eSpark-Backup/ezlo-ambient-tracker-pro-airbnb-hw/Deliverables/Main-PCB-v1.0/Renderings/3D_Top_View.png

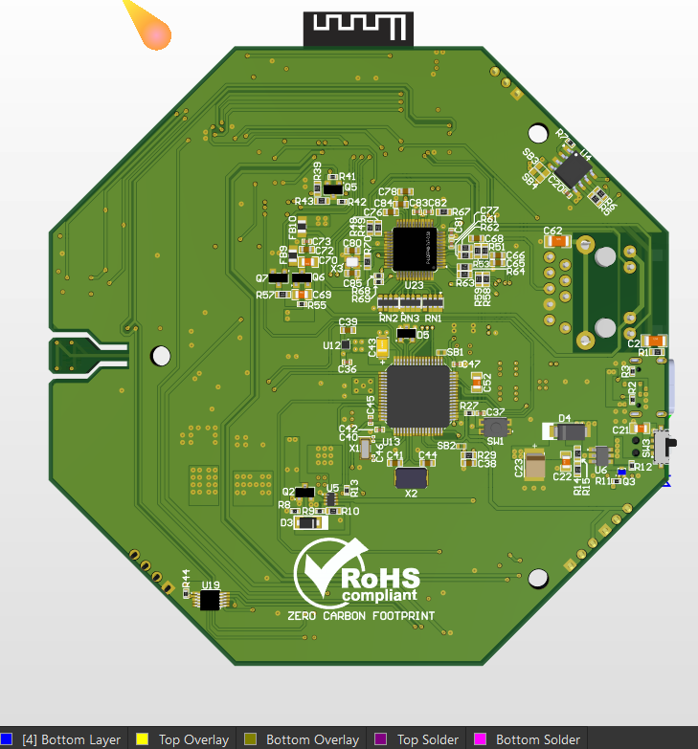
Deliverables/Main-PCB-v1.0/Renderings/3D_Top_View.png
