eSpark-Backup/ezlo-ambient-tracker-pro-airbnb-hw/(list of files, cad)

Other CAD files:
Deliverables/Main-PCB-v1.0/Supporting Files/AirBnB-v1.0.DWG
