eSpark-Backup/ezlo-ambient-tracker-pro-airbnb-hw/(list of files, drawings)

Other design files:
Design-Files/SecondaryPCB-airbnb/Secondary-PCB.PcbDoc
Design-Files/tracker-pro-airbnb-v1.0/Top-Sheet.SchDoc
