eSpark-Backup/ezlo-ambient-tracker-pro-airbnb-hw/Deliverables/Main-PCB-v1.0/Assembly Drawings/tracker-pro-airbnb-v1.0.pdf

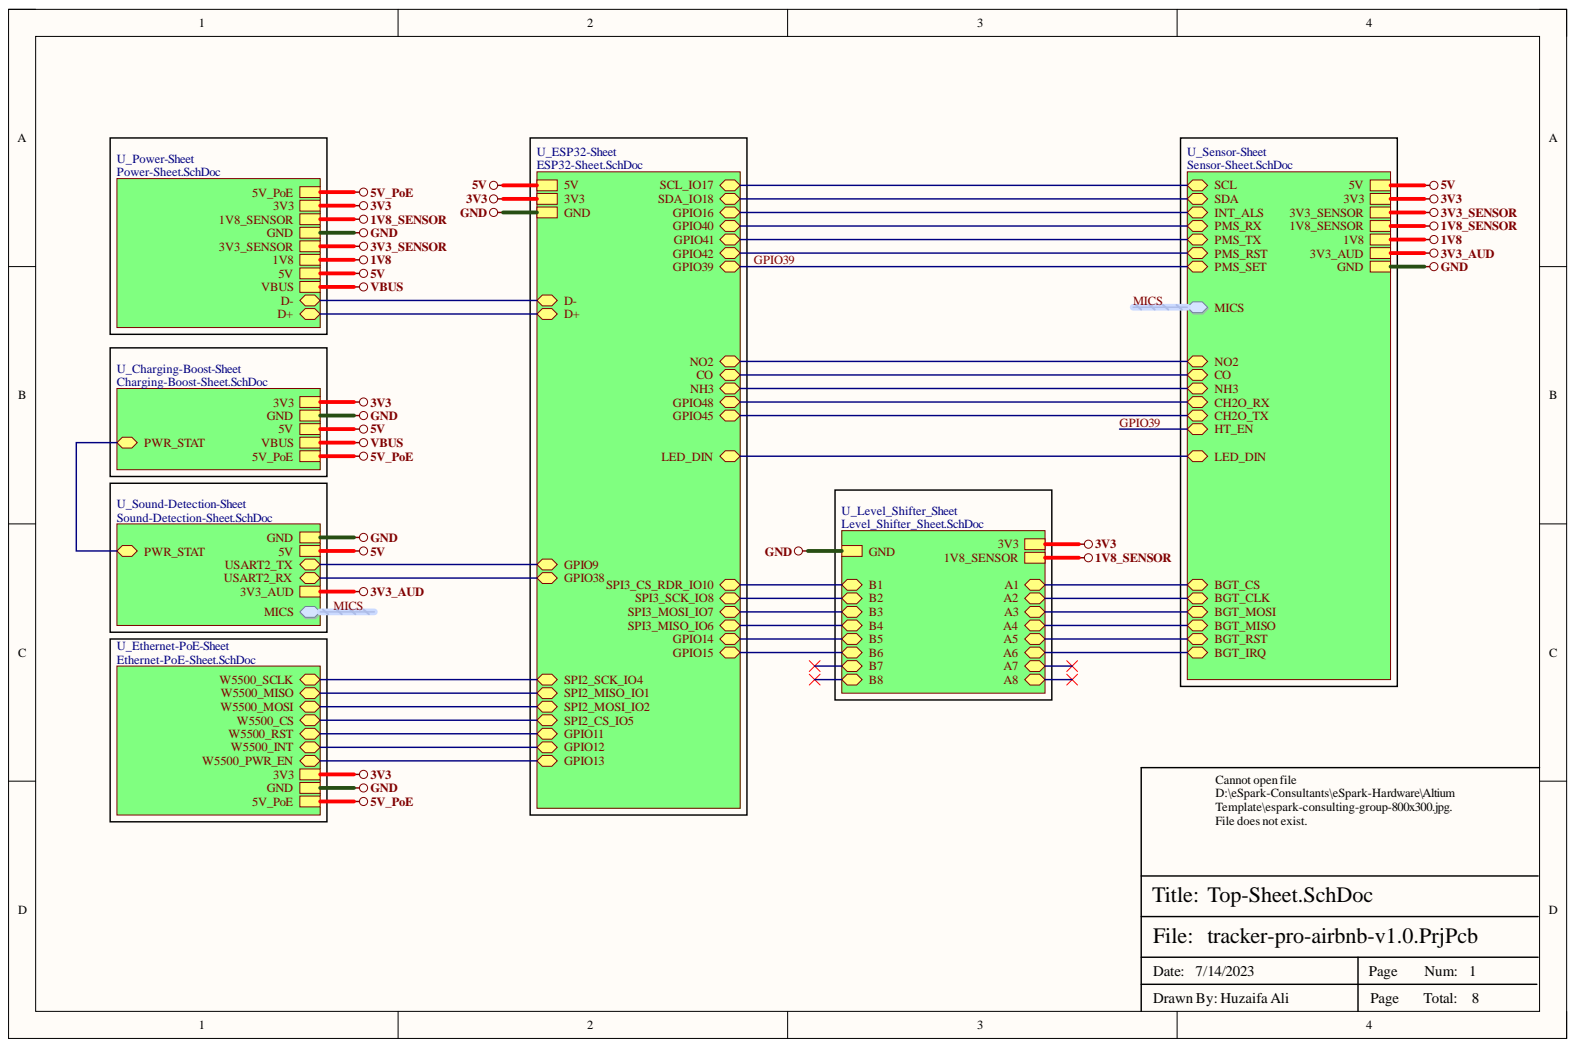
[picture p2: page 1]

U_Charging-Boost-Sheet
Charging-Boost-Sheet.SchDoc

U_Sound-Detection-Sheet
Sound-Detection-Sheet.SchDoc

U_Ethernet-PoE-Sheet
Ethernet-PoE-Sheet.SchDoc

Cannot open file
D:\eSpark-Consultants\eSpark-Hardware\Altium
Template\espark-consulting-group-800x300.jpg.
File does not exist.

tracker-pro-airbnb-v1.0.PrjPcb

Date: 7/14/2023 | Page Num: 1

Drawn By: Huzaifa Ali | Page Total: 8

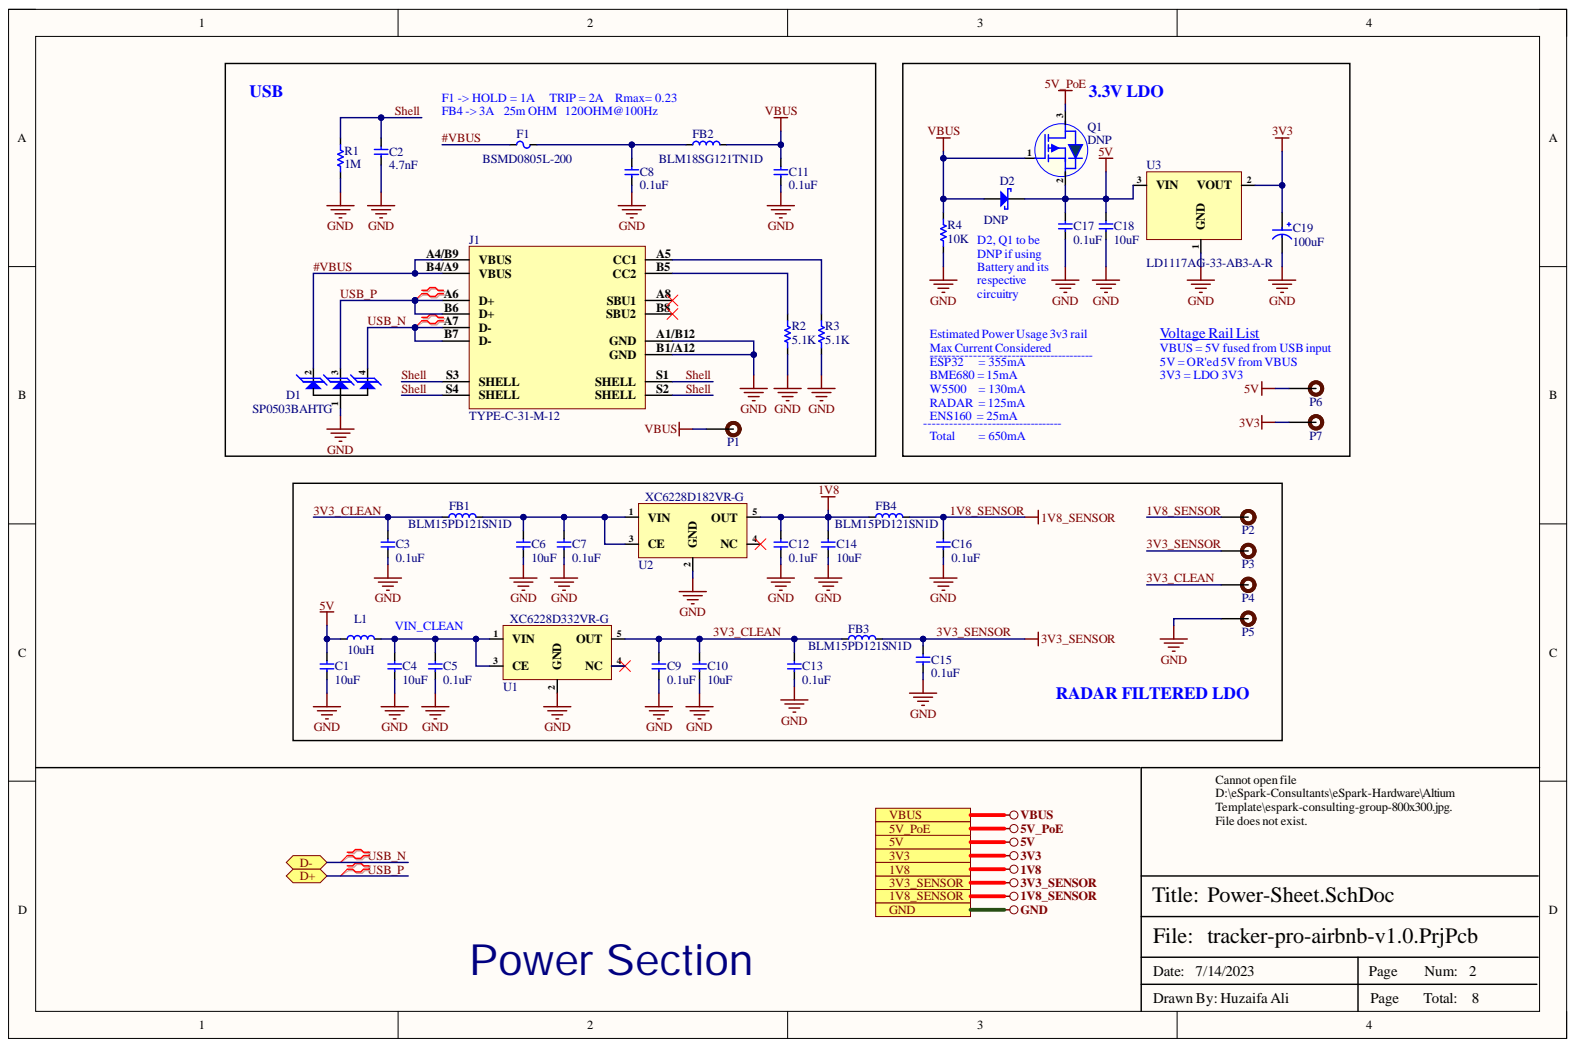
[picture p3: page 2]

USB_N | D+ B6

Estimated Power Usage 3v3 rail

Voltage Rail List VBUS = 5V fused from USB input

5V = OR'ed 5V from VBUS
3V3 = LDO 3V3

Shell

Cannot open file
D:\eSpark-Consultants\eSpark-Hardware\Altium
Template\espark-consulting-group-800x300.jpg.
File does not exist.

tracker-pro-airbnb-v1.0.PrjPcb

Date: 7/14/2023 | Page Num: 2

Drawn By: Huzaifa Ali | Page Total: 8

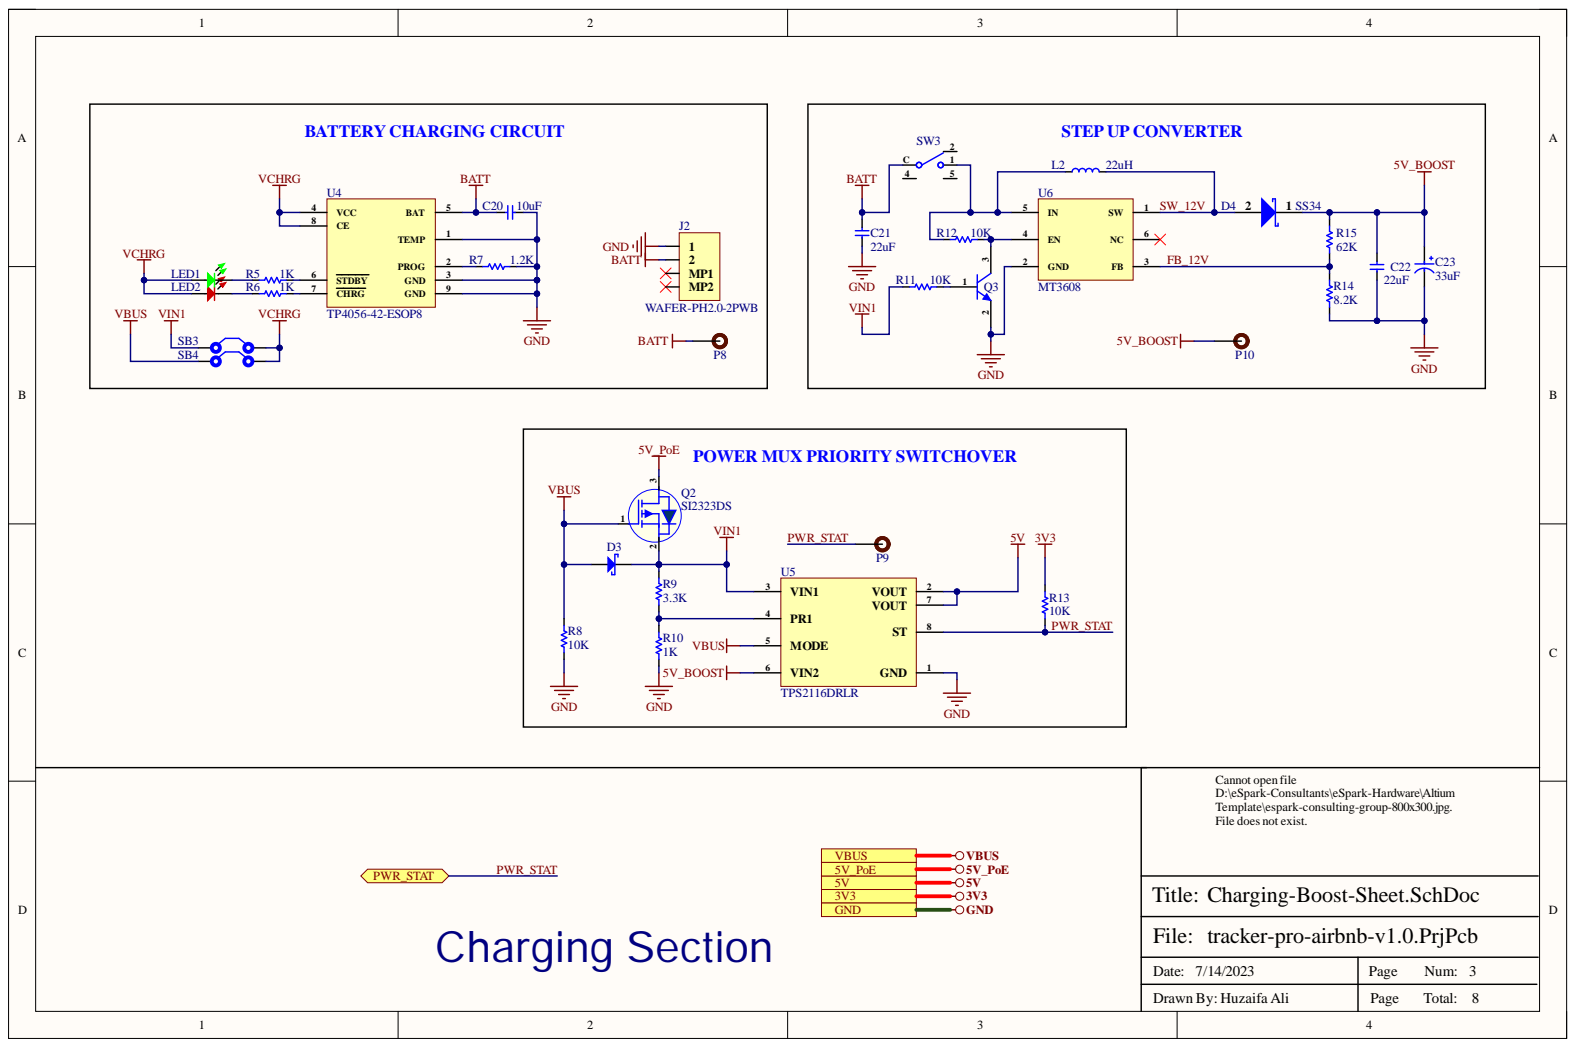
[picture p4: page 3]

POWER MUX PRIORITY SWITCHOVER

Cannot open file
D:\eSpark-Consultants\eSpark-Hardware\Altium
Template\espark-consulting-group-800x300.jpg.
File does not exist.

Charging-Boost-Sheet.SchDoc

tracker-pro-airbnb-v1.0.PrjPcb

Date: 7/14/2023 | Page Num: 3

Drawn By: Huzaifa Ali | Page Total: 8

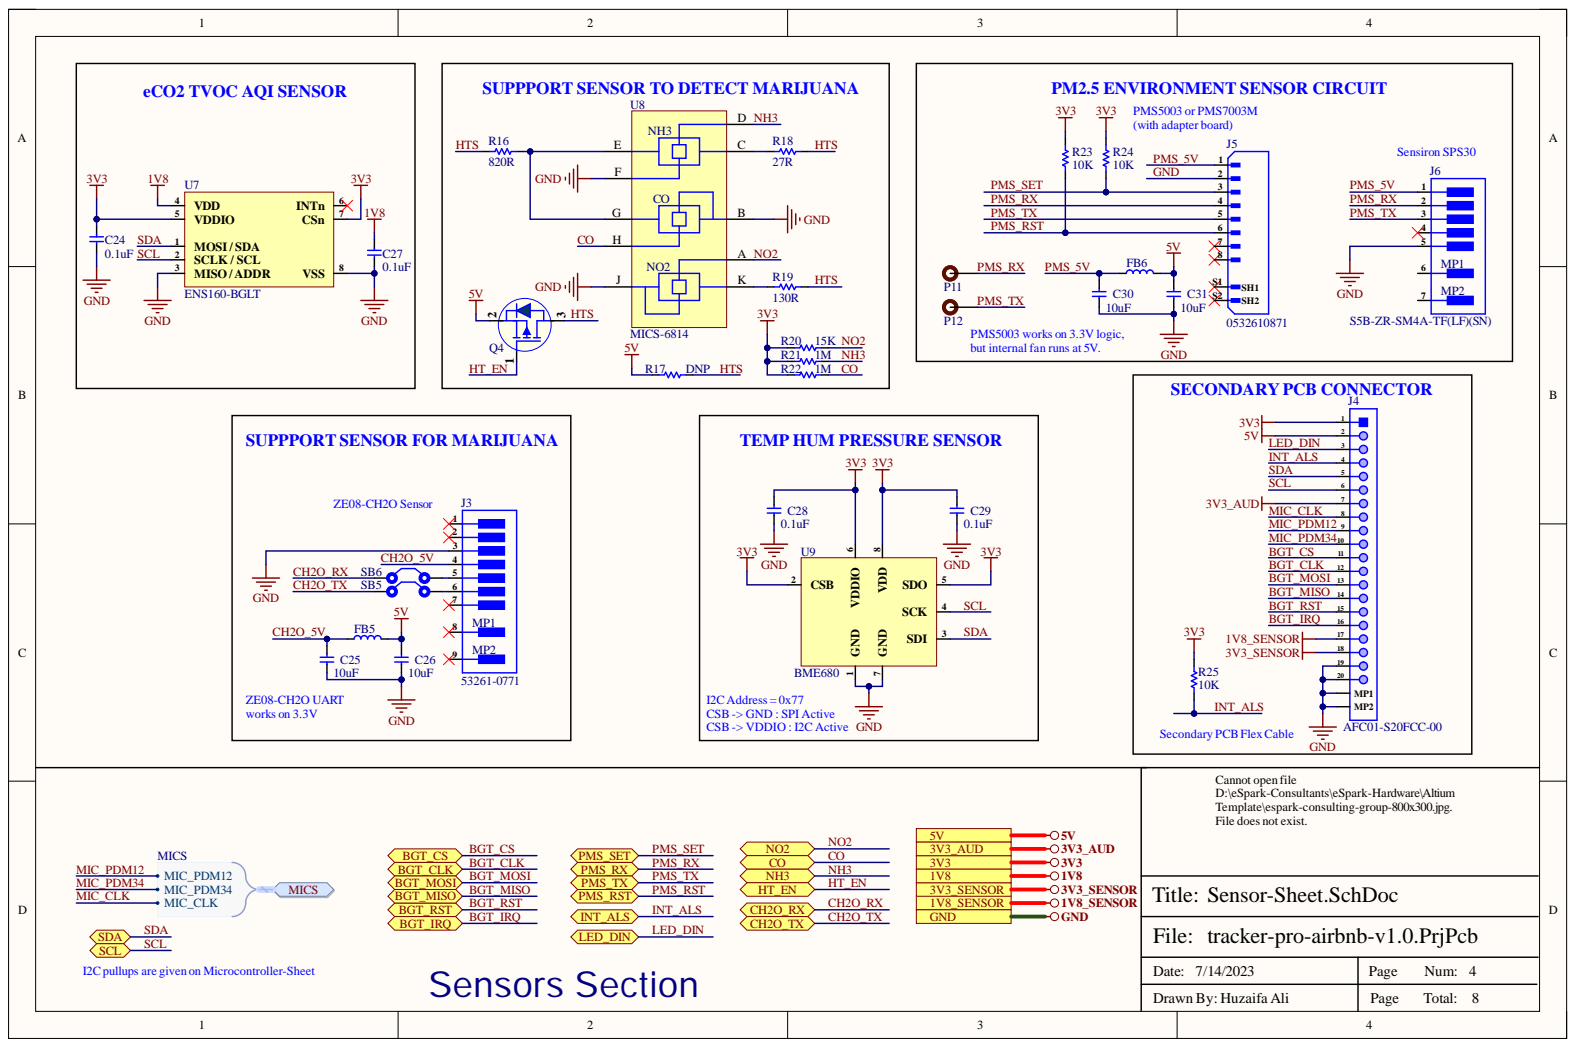
[picture p5: page 4]

PMS5003 works on 3.3V logic,
but internal fan runs at 5V.

TEMP HUM PRESSURE SENSOR

I2C Address = 0x77
CSB -> GND : SPI Active
CSB -> VDDIO : I2C Active GND

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

tracker-pro-airbnb-v1.0.PrjPcb

I2Cpullups are given on Microcontroller-Sheet

Date: 7/14/2023 | Page Num: 4

Drawn By: Huzaifa Ali | Page Total: 8

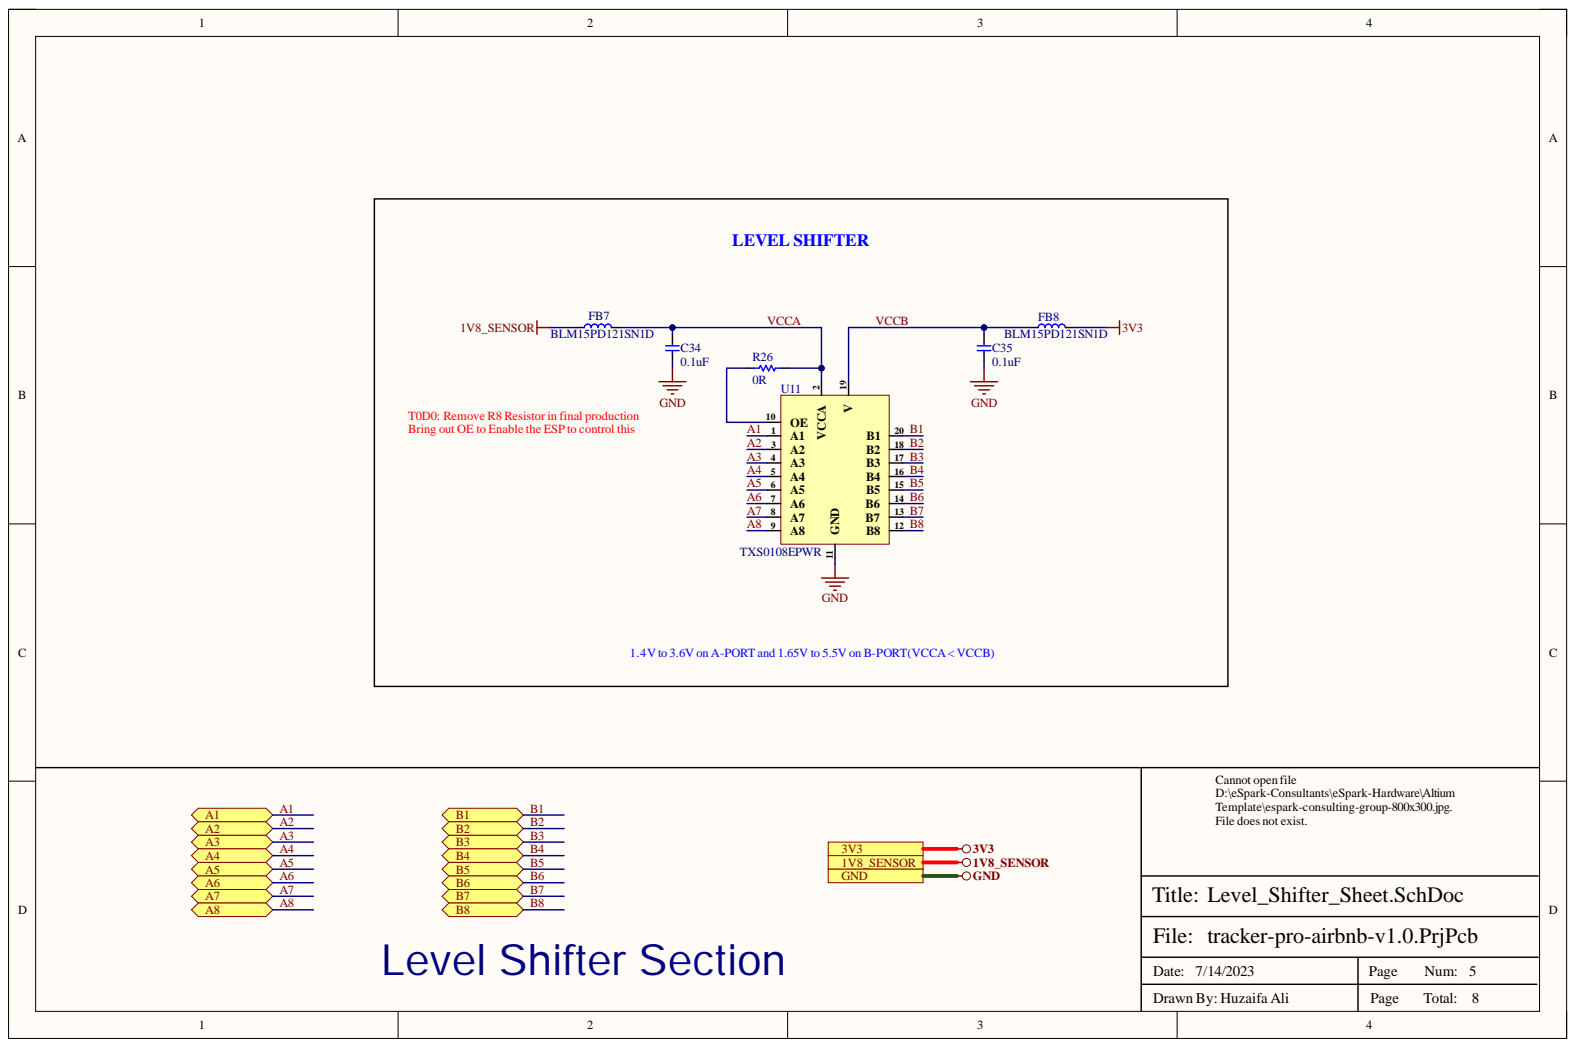
[picture p6: page 5]

T0D0: Remove R8 Resistor in final production
Bring out OE to Enable the ESP to control this

1.4V to 3.6V on A-PORT and 1.65V to 5.5V on B-PORT(VCCA< VCCB)

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

tracker-pro-airbnb-v1.0.PrjPcb

Date: 7/14/2023 | Page Num: 5

Drawn By: Huzaifa Ali | Page Total: 8

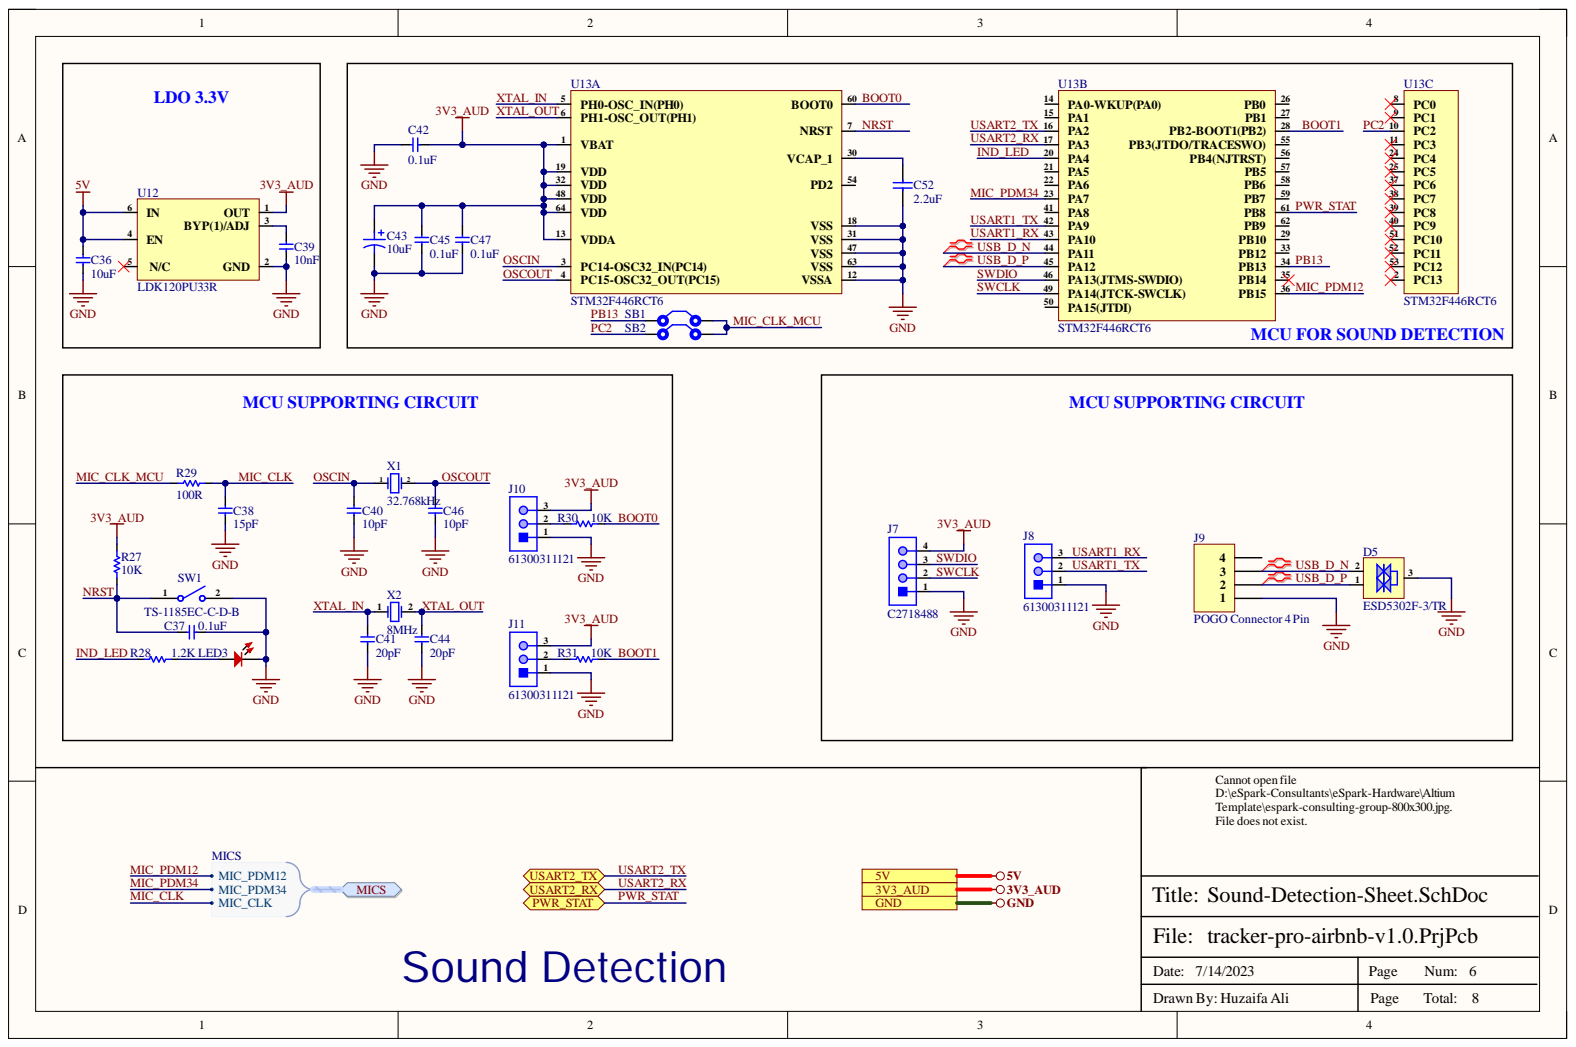
[picture p7: page 6]

MCU FOR SOUND DETECTION

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

Sound-Detection-Sheet.SchDoc

tracker-pro-airbnb-v1.0.PrjPcb

Date: 7/14/2023 | Page Num: 6

Drawn By: Huzaifa Ali | Page Total: 8

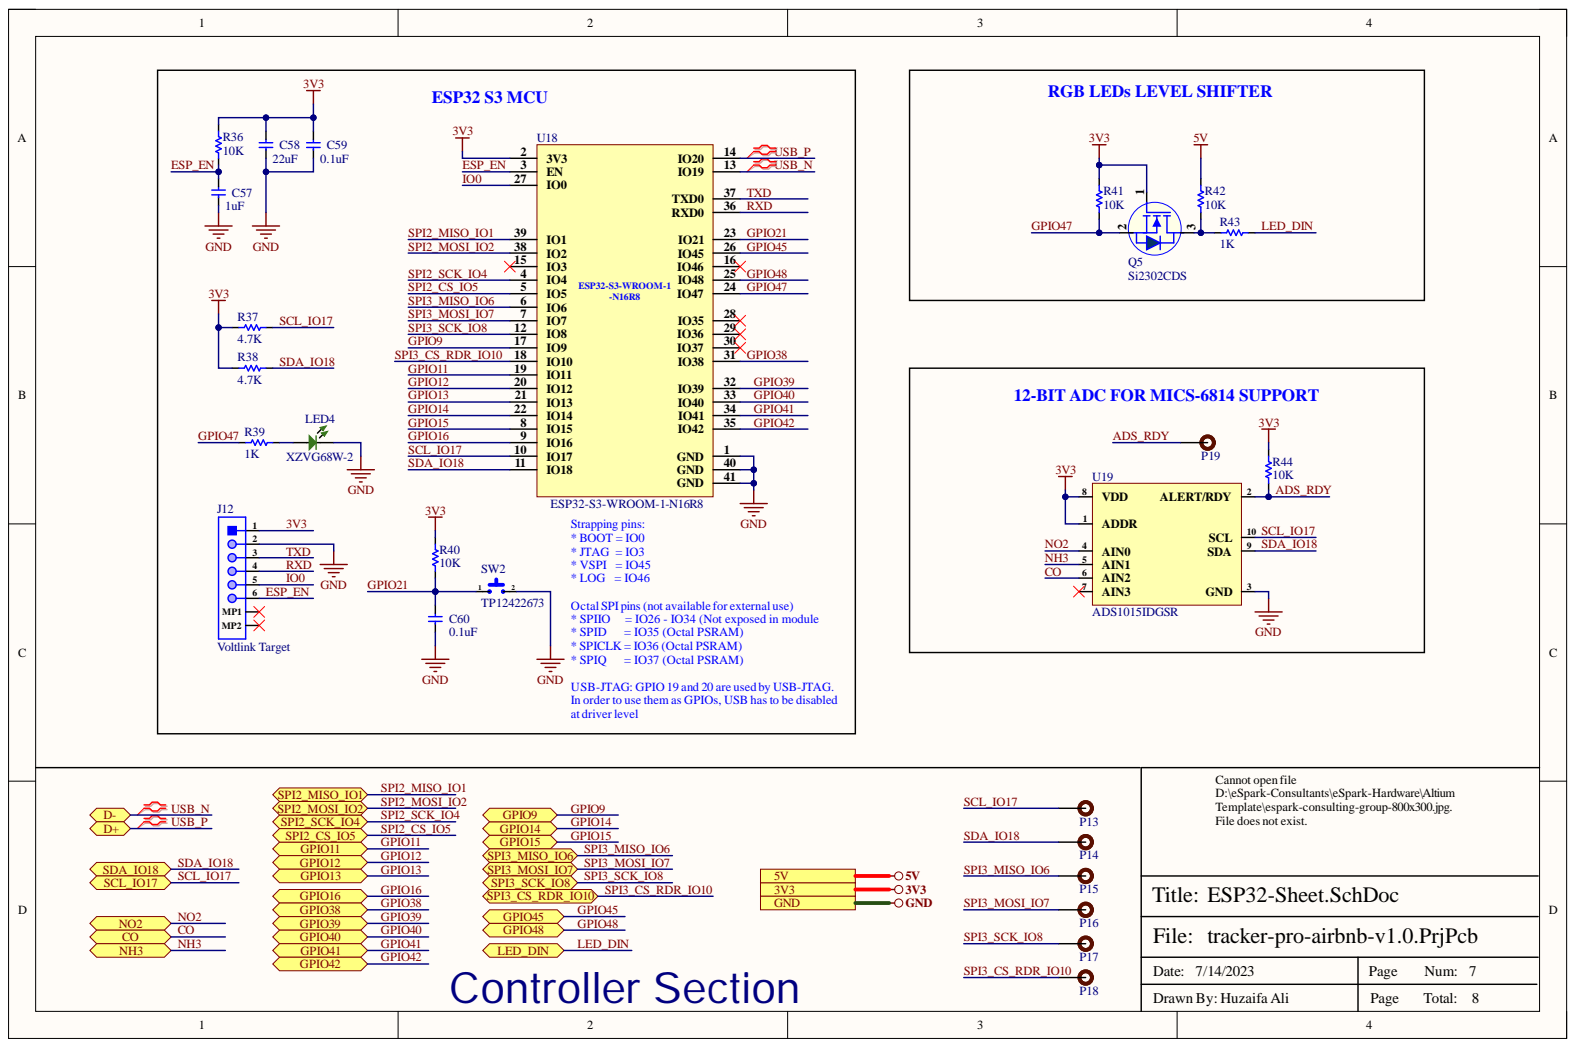
[picture p8: page 7]

RGB LEDs LEVEL SHIFTER

12-BIT ADC FOR MICS-6814 SUPPORT

Octal SPI pins (not available for external use)
* SPICLK = IO36 (Octal PSRAM)

USB-JTAG: GPIO 19 and 20 are used by USB-JTAG.
In order to use them as GPIOs, USB has to be disabled
at driver level

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

tracker-pro-airbnb-v1.0.PrjPcb

Date: 7/14/2023 | Page Num: 7

Drawn By: Huzaifa Ali | Page Total: 8

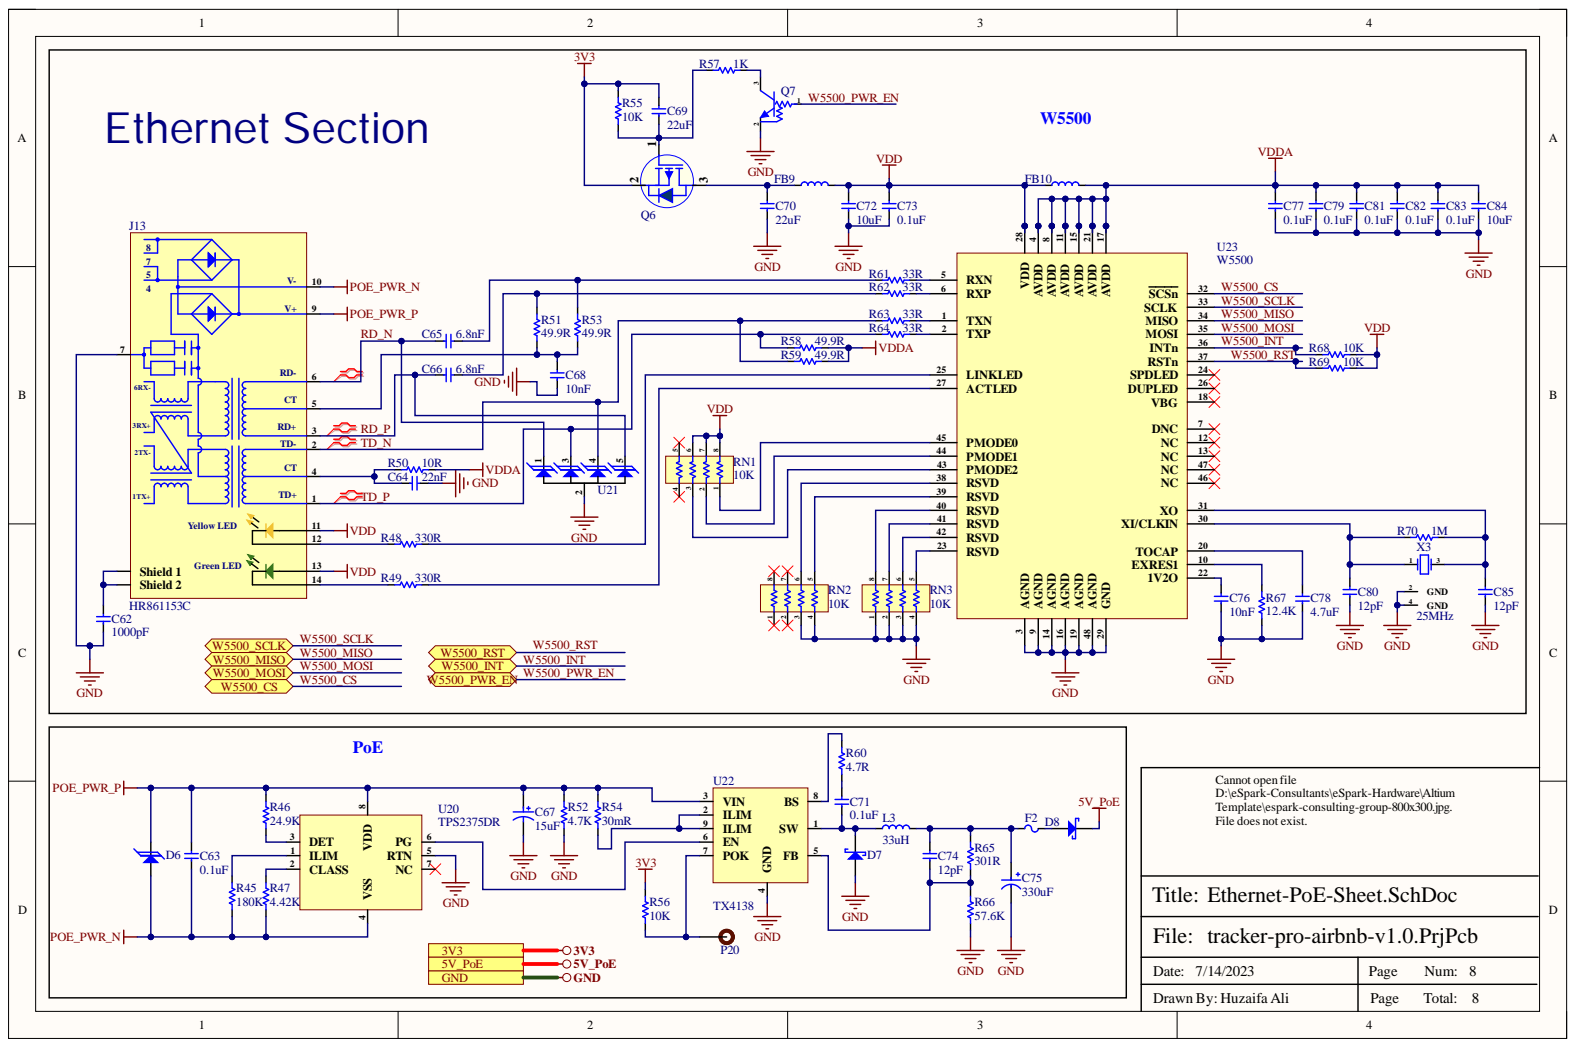
[picture p9: page 8]
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

Ethernet-PoE-Sheet.SchDoc

tracker-pro-airbnb-v1.0.PrjPcb

Date: 7/14/2023 | Page Num: 8

Drawn By: Huzaifa Ali | Page Total: 8

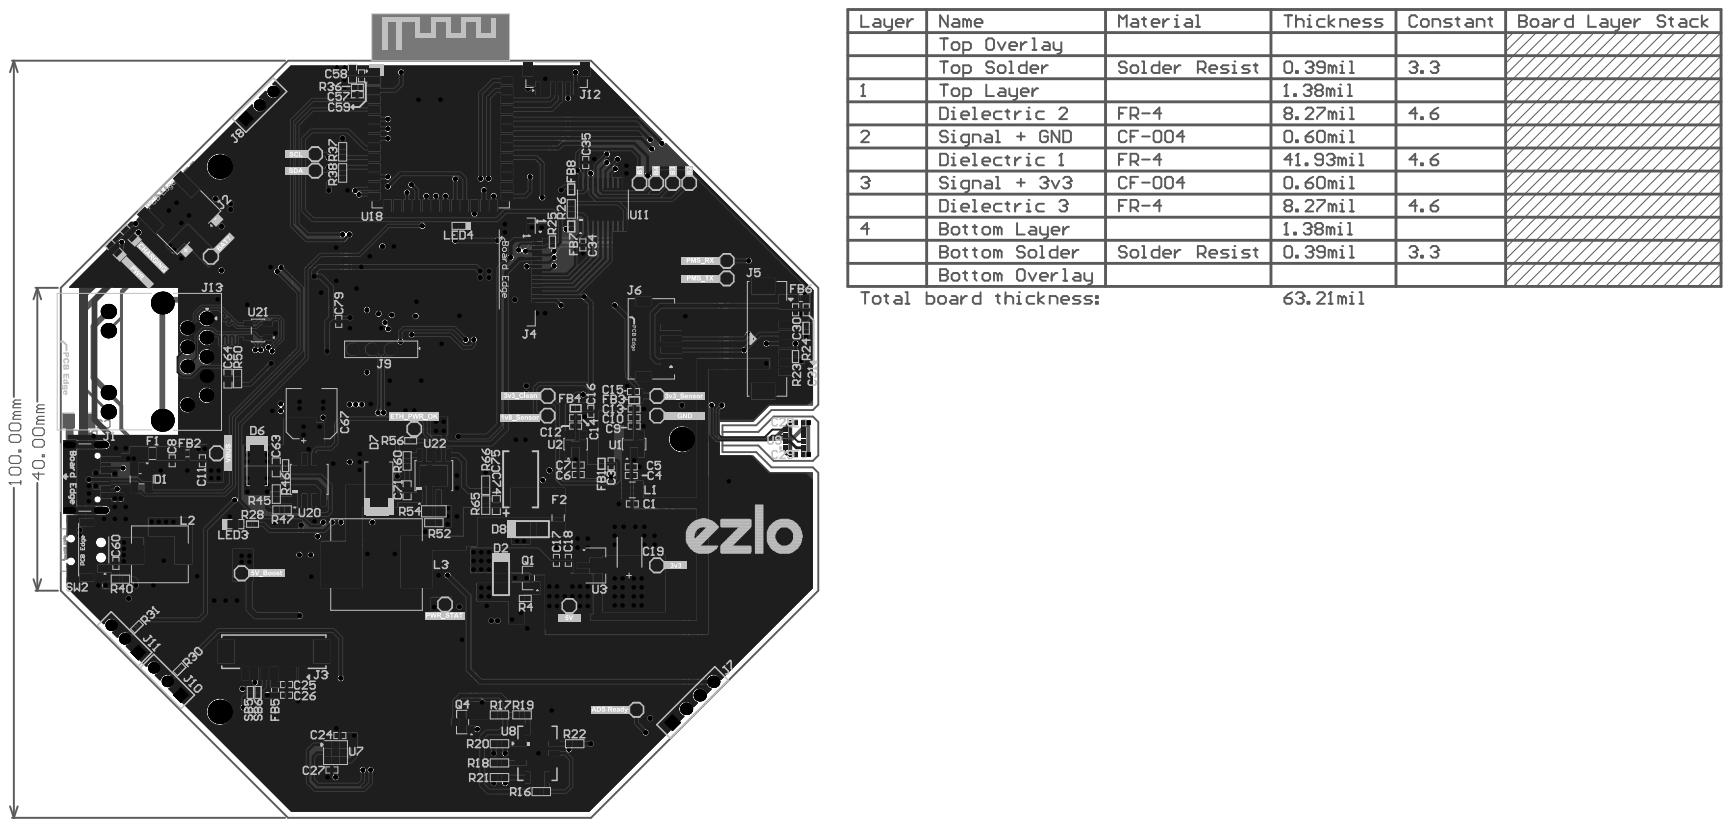
[picture p10: page 9]
