eSpark-Backup/ezlo-ambient-tracker-pro-airbnb-hw/(commit log)

2023-05-31 Schematic designing #1 (In progress)
2023-06-02 ESP32 GPIOs assigned #1
2023-06-07 #1 Schematic Updated
2023-06-09 #1 Sensors, power section, battery charger, mics added
2023-06-12 #1 Schematic Completed - Discussion remaining
2023-06-14 #1 Ethernet connector flipped added - 3.3V reg changed - PDF generated
2023-06-14 #1 Connector update
2023-06-15 #1 Capacitors updated - PDF updated
2023-06-15 #1 PWR Stat connected to STM32 - PDF Updated
2023-06-15 #4 eSpark BOM in Progress
2023-06-16 #1 Test points footprint library updated
2023-06-16 #1 Fuse updated for BOM
2023-06-16 #1 Resistors updated for BOM
2023-06-20 #4 Schematic parts updated for BOM non stock parts
2023-06-20 #4 Buttons updated
2023-06-20 #3 Placement done. Needs to be verified with enclosure
2023-06-20 #4 Required SW2 switch updated - PCB Requirement
2023-06-21 #1 SW2 had footprint issue. Dragged it from centralized library. No change in the schematic
2023-06-25 #3 PMS connector Moved. MICs placed at Equidistant.
2023-07-05 #6 Schematic Complete
2023-07-05 #1 #6 Changes done after addition of Secondary PCB
2023-07-05 #6 Schematic updated with 5 LEDs
2023-07-07 #4 eSpark BOM Updated
2023-07-07 #8 #6 #7 R1 changed because of BOM requirement
2023-07-07 #8 eSpark BOM Completed
2023-07-08 R1 updated in PCB
2023-07-10 #4 Capacitors adjusted for BOM
2023-07-10 #4 Extra part no of Capacitor Removes
2023-07-10 #3 In-Progress (connector needs to be moved and their traces will need to re-route)
2023-07-11 #7 Connector updated acc to shared DXF
2023-07-12 FPC J1 connector pinout inverted due to placement requirement
2023-07-12 #7 J1 updated in PCB, mounting hole moved 2mm upwards
2023-07-12 Mic track updated
2023-07-12 Mountings hole moved 3mm upwards
2023-07-12 #3 Moved PoE's L3 Circuitry. Finishing and DRC errors remaining
2023-07-13 #3 Overlay changed from STANDBY to PWR for Battery LED
2023-07-13 #1 U3 LDO symbol and footprint changed.
2023-07-13 #3 Design Completed after LDO footprint modification.
2023-07-13 #4 R56 Resistor Edited in BOM
2023-07-13 #8 Ribbon Added In BOM
2023-07-13 #5 X1 and J1 footprints updated in PCB. Fresh Deliveables created.
2023-07-14 #3 Signals/GPIO45 updated in PCB #10 Fresh deliverables generated accordingly
2023-07-14 #1 Solder Bridges added for ZE08 sensor UART
2023-07-14 #3 Solder Bridge updated in PCB and Fresh deliverables generated
2023-07-14 #4 SB5, SB6 Added in BOM
